markusgruen/RTMC/Hardware/RTMChub/RTMChub_V0.1_page1of2.pdf

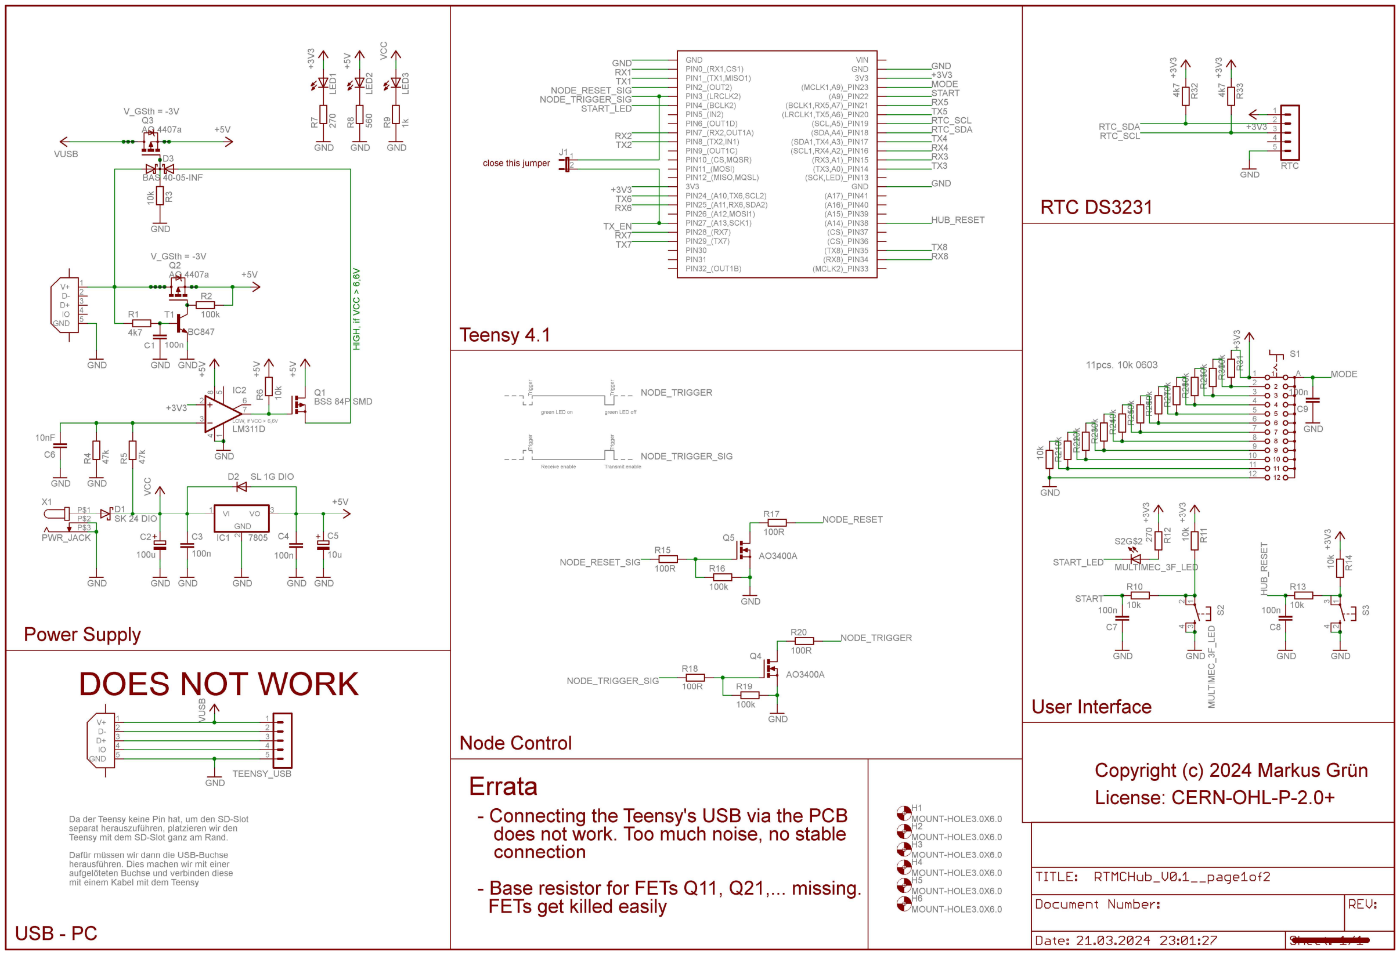
[picture p8: page 1]
