markusgruen/RTMC/Hardware/RTMChub/RTMChub_V0.1_page2of2.pdf

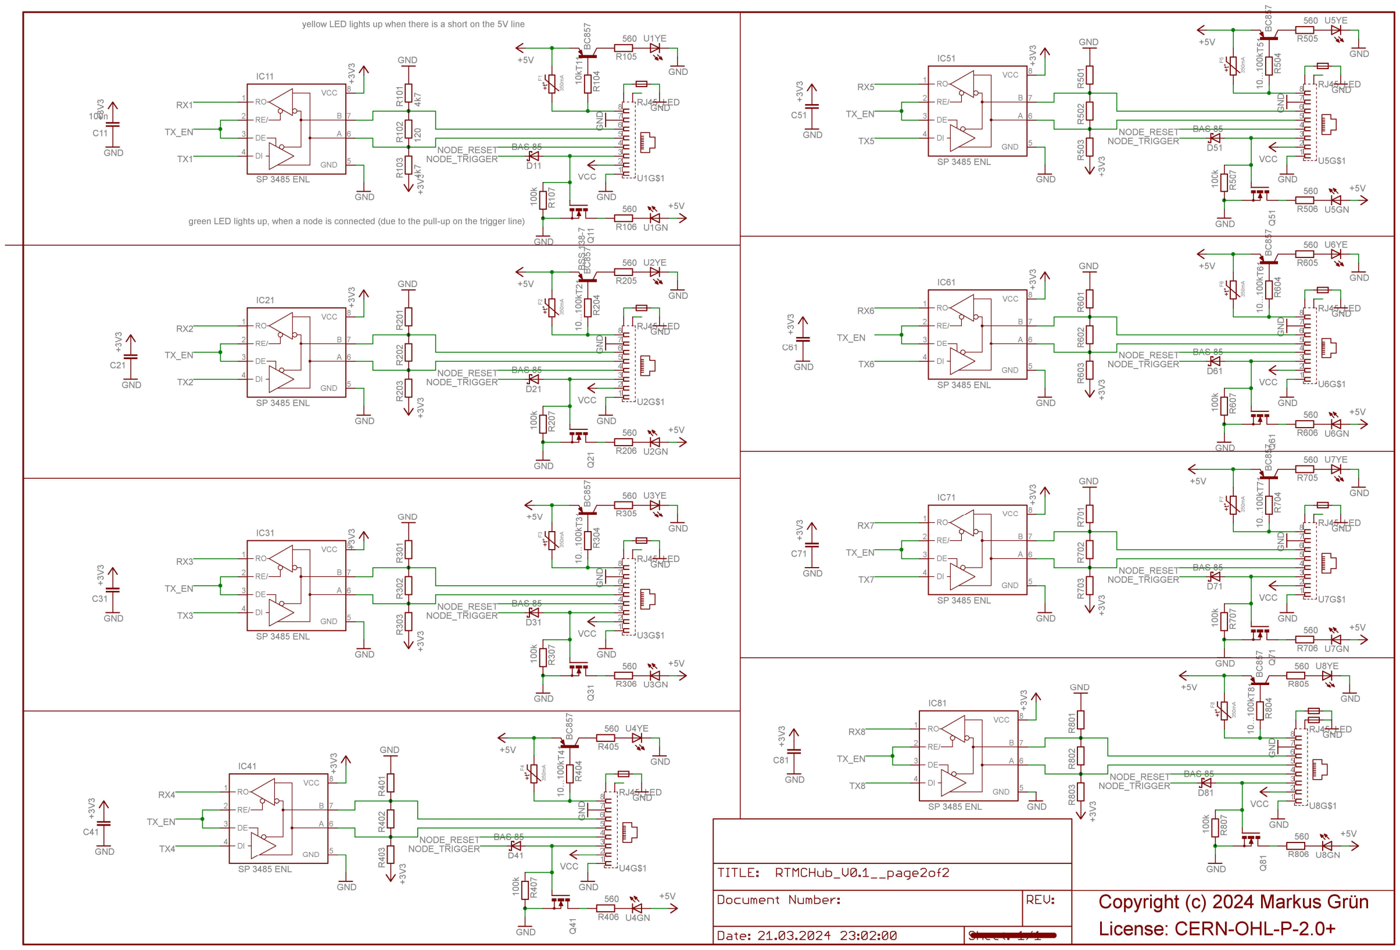
[picture p9: page 1]
