markusgruen/RTMC/Hardware/RTMCnode/RTMCnode_V0.1.pdf

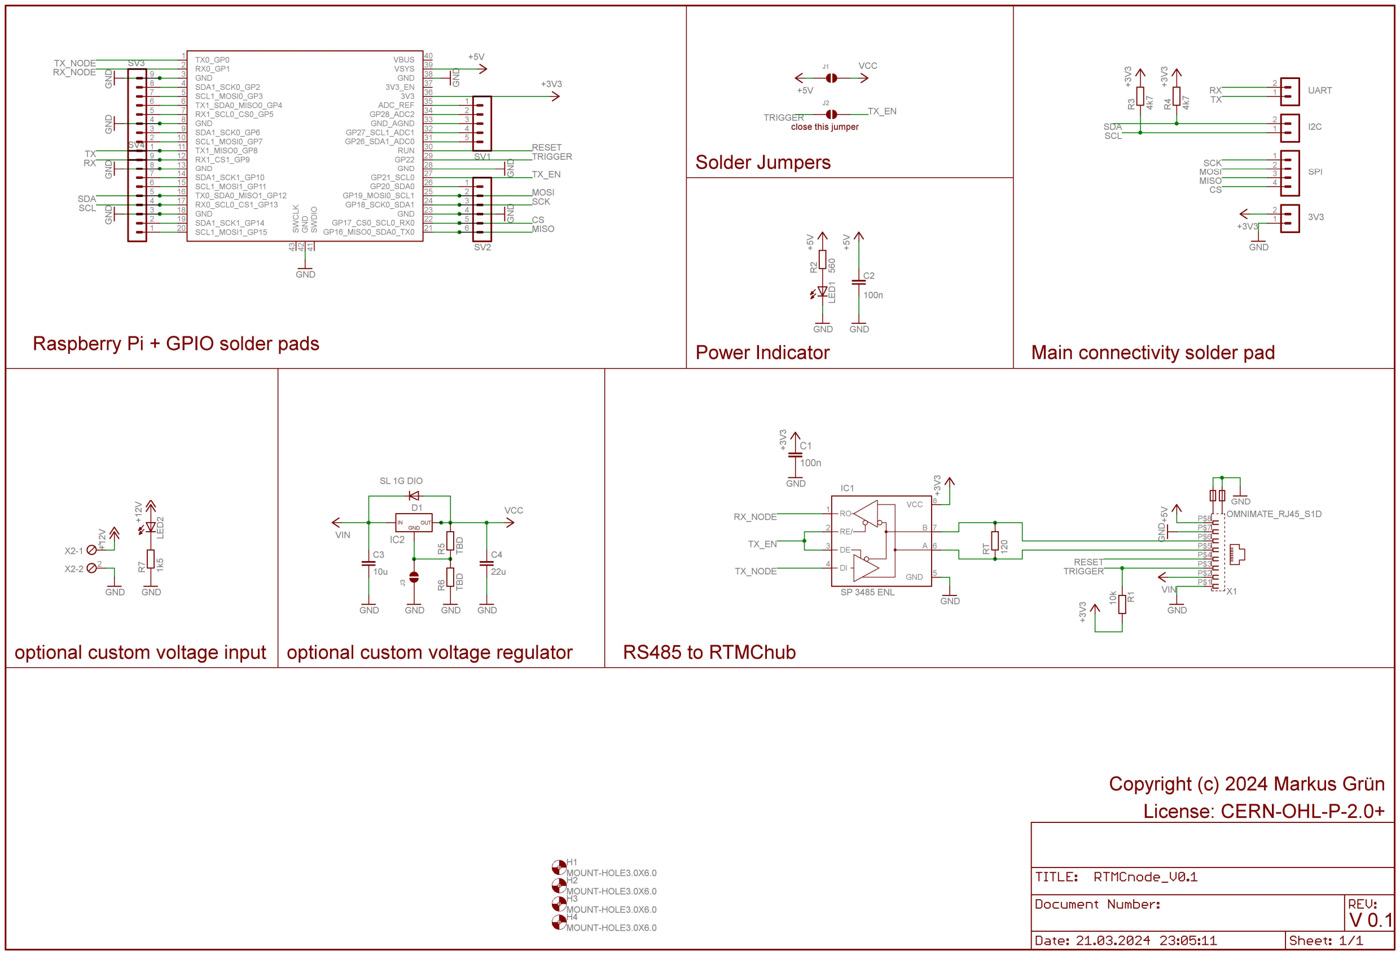
[picture p10: page 1]
