markusgruen/RTMC/doc/Arduino_ADXL355.jpg

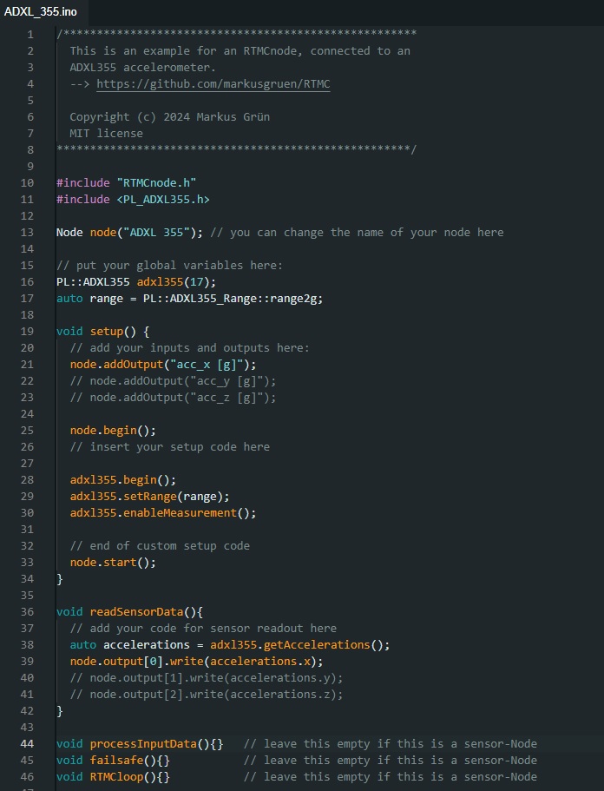
doc/Arduino_ADXL355.jpg
