markusgruen/RTMC/doc/RTMC-node_1.jpg

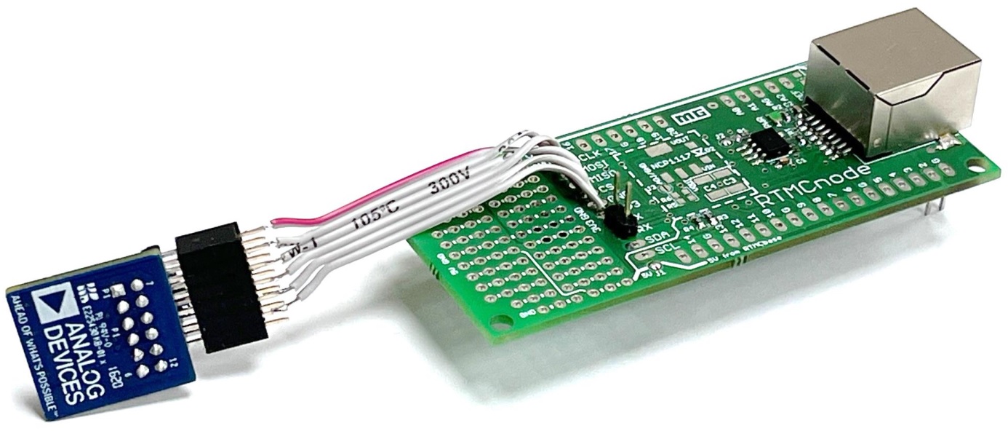
doc/RTMC-node_1.jpg
