markusgruen/RTMC/doc/RTMC-node_3.jpg

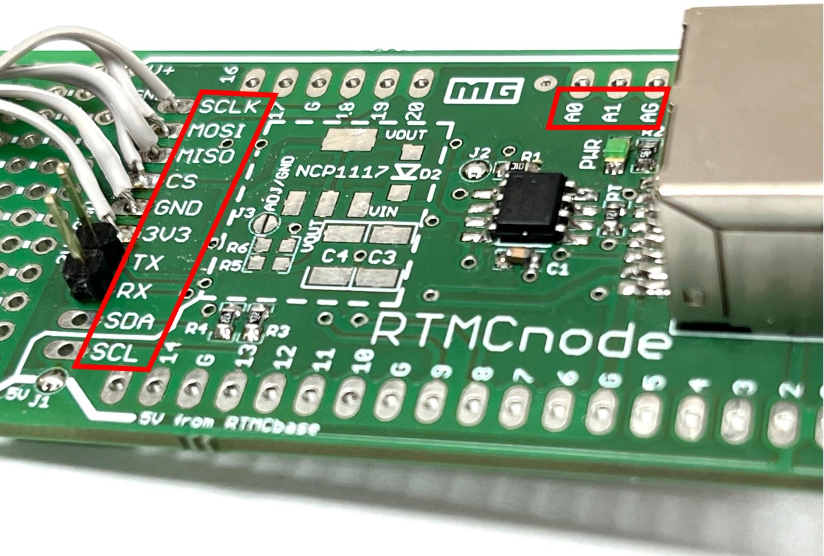
doc/RTMC-node_3.jpg
