markusgruen/RTMC/Hardware/BOM.xlsx

Sheet: RTMhub
 | Qty | Name | Value | Function | Remark | Reichelt Order No. | Reichelt Link
Teensy & Node Control | 1 | UC1 | Teensy 4.1 | µC | do not solder on PCB, use pinheader | TEENSY 4.1 | https://www.reichelt.de/teensy-4-1-usb-ohne-header-teensy-4-1-p283580.html?search=teensy
 | 2 | - | male Pinheader 1x24 | Pinheader for Teensy |  | MPE 087-1-024 | https://www.reichelt.de/stiftleisten-2-54-mm-1x24-gerade-mpe-087-1-024-p119889.html?trstct=vrt_pdn&nbc=1
 | 2 | - | female Pinheader 1x26 | Socket for Teensy | shorten to 1x24 | BKL 10120954 | https://www.reichelt.de/buchsenleiste-2-54mm-1x26-gerade-bkl-10120954-p266679.html?&nbc=1
 | 1 | J1 | male Pinheader 1x2 | Jumper | jumper required | MPE 087-1-002 | https://www.reichelt.de/stiftleisten-2-54-mm-1x02-gerade-mpe-087-1-002-p119879.html?trstct=pol_0&nbc=1
 | 4 | R15, R17, R18, R20 | 100R |  |  | SMD-0603 100 | https://www.reichelt.de/smd-widerstand-0603-100-ohm-100-mw-1--smd-0603-100-p89418.html?&nbc=1
 | 2 | R16, R19 | 100k |  |  | SMD-0603 100K | https://www.reichelt.de/smd-widerstand-0603-100-kohm-100-mw-1--smd-0603-100k-p89454.html?&nbc=1
 | 2 | Q4, Q5 | AO3400A | N-ch Mosfet |  | AO3400A | https://www.reichelt.de/mosfet-n-kanal-30-v-5-7-a-rds-on-0-018-ohm-sot-23-ao3400a-p166490.html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
User Interface | 1 | S1 | Rotary Switch, 1x12 | Mode switch |  | DS 1PC | https://www.reichelt.de/stufen-drehschalter-1-pol-12-stellungen-printk--ds-1pc-p7211.html?&nbc=1
 | 1 | S2 | Multimec Button, LED | Start button |  | TASTER 3FTH980 | https://www.reichelt.de/multimec-taster-led-beleuchtung-rt-taster-3fth980-p79702.html?&nbc=1
 | 1 | - | Cap for Multimec | Cap for Start button |  | KAPPE 1D11 | https://www.reichelt.de/kappe-fuer-taster-3f-rund-trans--kappe-1d11-p82189.html?&nbc=1
 | 1 | S3 | SMD button | Reset Button |  | TASTER 9315 | https://www.reichelt.de/smd-kurzhubtaster-vert-montage-hoehe-5-0mm-taster-9315-p44514.html?trstct=pol_12&nbc=1
 | 4 | R10, R11, R13, R14 | 10k |  |  | SMD-0603 10K | https://www.reichelt.de/smd-widerstand-0603-10-kohm-100-mw-1--smd-0603-10k-p89442.html?&nbc=1
 | 1 | R12 | 270R |  |  | SMD-0603 120 | https://www.reichelt.de/smd-widerstand-0603-120-ohm-100-mw-1--smd-0603-120-p89419.html?trstct=pos_0&nbc=1
 | 11 | R21…R31 | 10k |  |  | SMD-0603 10K | https://www.reichelt.de/smd-widerstand-0603-10-kohm-100-mw-1--smd-0603-10k-p89442.html?&nbc=1
 | 3 | C7, C8, C9 | 100n | Decoupling condensator |  | X7R-G0603 100N | https://www.reichelt.de/smd-vielschicht-0603-100-nf-10-16-v-x7r-125-c-ve-4k-x7r-g0603-100n-p31873.html?nbc=1
Power Supply | 1 | IC1 | LM7805 | Voltage Regulator | or similar Vreg | µA 7805 | https://www.reichelt.de/spannungsregler-fest-4-8--5-2-v-to-220--a-7805-p23443.html?trstct=pos_0&nbc=1
 | 1 | IC2 | LM311D | Komparator |  | LM 311 D SMD | https://www.reichelt.de/komparator-1-fach-so-8-lm-311-d-smd-p18712.html?&nbc=1
 | 1 | Q1 | BSS 84P | P-ch Mosfet |  | BSS 84P SMD | https://www.reichelt.de/mosfet-p-kanal-50-v-0-13-a-0-3-w-sot-23-bss-84p-smd-p41443.html?&nbc=1
 | 2 | Q2, Q3 | AO 4407a | P-ch Mosfet |  | AO 4407A | https://www.reichelt.de/mosfet-p-kanal-30-v-12-a-rds-on-0-0085-ohm-so-8-ao-4407a-p166495.html?&nbc=1
 | 1 | T1 | BC847 | NPN transistor |  | BC 847C DIO | https://www.reichelt.de/bipolartransistor-npn-45v-0-1a-0-25w-sot-23-bc-847c-dio-p219190.html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
 | 1 | D1 | SK 24 DIO | Schottky Diode |  | SK 24 DIO | https://www.reichelt.de/schottkydiode-40-v-2-a-do-214aa-sk-24-dio-p219596.html?&nbc=1
 | 1 | D2 | SL 1G DIO | Recovery diode |  | SL 1G DIO | https://www.reichelt.de/gleichrichterdiode-400-v-1-a-sod-123-sl-1g-dio-p219603.html?&nbc=1
 | 1 | D3 | BAS 40-05-INF | Dual Schottky Diode |  | BAS 40-05 INF | https://www.reichelt.de/duale-schottky-dioden-gemeinsame-kathode-40-v-0-12-a-sot-23-bas-40-05-inf-p219312.html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
 | 1 | R1 | 4k7 |  |  | SMD-0603 4,7K | https://www.reichelt.de/smd-widerstand-0603-4-7-kohm-100-mw-1--smd-0603-4-7k-p89438.html?&nbc=1
 | 1 | R2 | 100k |  |  | SMD-0603 100K | https://www.reichelt.de/smd-widerstand-0603-100-kohm-100-mw-1--smd-0603-100k-p89454.html?&nbc=1
 | 2 | R3, R6 | 10k |  |  | SMD-0603 10K | https://www.reichelt.de/smd-widerstand-0603-10-kohm-100-mw-1--smd-0603-10k-p89442.html?&nbc=1
 | 2 | R4, R5 | 47k |  |  | SMD-0603 47K | https://www.reichelt.de/smd-widerstand-0603-47-kohm-100-mw-1--smd-0603-47k-p89450.html?trstct=pos_0&nbc=1
 | 1 | R7 | 270R |  |  | SMD-0603 270 | https://www.reichelt.de/smd-widerstand-0603-270-ohm-100-mw-1--smd-0603-270-p89423.html?trstct=pos_0&nbc=1
 | 1 | R8 | 560R | LED resistor |  | SMD-0603 560 | https://www.reichelt.de/smd-widerstand-0603-560-ohm-100-mw-1--smd-0603-560-p89427.html?&nbc=1
 | 1 | R9 | 1k |  |  | SMD-0603 1,0K | https://www.reichelt.de/smd-widerstand-0603-1-0-kohm-100-mw-1--smd-0603-1-0k-p89430.html?trstct=pol_0&nbc=1
 | 3 | C1, C3, C4 | 100n | Decoupling condensator |  | X7R-G0603 100N | https://www.reichelt.de/smd-vielschicht-0603-100-nf-10-16-v-x7r-125-c-ve-4k-x7r-g0603-100n-p31873.html?nbc=1
 | 1 | C6 | 10n |  |  | X7R-G0603 10N | https://www.reichelt.de/smd-vielschicht-keramikkondensator-10n-10--x7r-g0603-10n-p31870.html?&nbc=1
 | 1 | C2 | 100u |  | adapt as required by the Vreg | FK 100/25 XP | https://www.reichelt.de/elko-smd-100-f-25v-105-c-low-esr-fk-100-25-xp-p175023.html?trstct=pol_2&nbc=1
 | 1 | C5 | 10u |  | adapt as required by the Vreg | SMD ELKO 10/16 | https://www.reichelt.de/smd-chip-elko-10-f-16volt-smd-elko-10-16-p31906.html?&nbc=1
 | 1 | X5 | Mirco USB | Micro USB for Power input |  | MIC USB ABBU | https://www.reichelt.de/micro-usb-einbaubuchse-typ-ab-5-pol-smd-mic-usb-abbu-p155040.html?trstct=pos_0&nbc=1
 | 1 | X1 | Power Jack | Power Input |  | CLIFF FCR681465P | https://www.reichelt.de/einbaukupplung-loetstifte-cliff-fcr681465p-p227726.html?&nbc=1
 | 3 | LED1…3 | LED 3mm | Power Indicator |  | LED 3MM GN | https://www.reichelt.de/led-3-mm-bedrahtet-gruen-74-mcd-38--led-3mm-gn-p10227.html?trstct=pol_5&nbc=1
8x Node Communication | 8 | IC11, IC21,…IC81 | SP 3485 ENL | RS485 Transceiver |  | SP 3485 ENL | https://www.reichelt.de/rs485-422-1-treiber-1-empfaenger-so-8-sp-3485-enl-p166271.html?&nbc=1
 | 16 | R101, R201,…, R801 R103, R203,…R803 | 4k7 |  |  | SMD-0603 4,7K | https://www.reichelt.de/smd-widerstand-0603-4-7-kohm-100-mw-1--smd-0603-4-7k-p89438.html?&nbc=1
 | 8 | R102, R202,…R802 | 120R | RS485 Terminator |  | SMD-0603 120 | https://www.reichelt.de/smd-widerstand-0603-120-ohm-100-mw-1--smd-0603-120-p89419.html?&nbc=1
 | 8 | R104, R204,…, R804 | 10k |  |  | SMD-0603 10K | https://www.reichelt.de/smd-widerstand-0603-10-kohm-100-mw-1--smd-0603-10k-p89442.html?&nbc=1
 | 16 | R105, R205,…, R805 R106, R206,…, R806 | 560R | LED resistor |  | SMD-0603 560 | https://www.reichelt.de/smd-widerstand-0603-560-ohm-100-mw-1--smd-0603-560-p89427.html?&nbc=1
 | 8 | R107, R207,…, R807 | 100k |  |  | SMD-0603 100K | https://www.reichelt.de/smd-widerstand-0603-100-kohm-100-mw-1--smd-0603-100k-p89454.html?&nbc=1
 | 8 | C11, C21, …., C81 | 100n | Decoupling condensator |  | X7R-G0603 100N | https://www.reichelt.de/smd-vielschicht-0603-100-nf-10-16-v-x7r-125-c-ve-4k-x7r-g0603-100n-p31873.html?nbc=1
 | 8 | F1…F8 | Polyfuse 350mA | Fuse |  | PTC FSMD0350805 | https://www.reichelt.de/ptc-sicherung-smd-0805-6v-350ma-rueckstellend-ptc-fsmd0350805-p279337.html?nbc=1
 | 8 | D11, D21,…D81 | BAS 85 | Schottky Diode |  | BAS 85 VIS | https://www.reichelt.de/kleinsignal-schottky-diode-30-v-0-2-a-sod-80-bas-85-vis-p219617.html?&nbc=1
 | 8 | Q11, Q21,…, Q81 | BSS 138 | N-ch Mosfet |  | BSS 138-7-F DII | https://www.reichelt.de/mosfet-n-ch-50v-0-2a-0-3w-sot-23-bss-138-7-f-dii-p219226.html?&nbc=1
 | 8 | T11, T21,…, T81 | BC857 | PNP transistor |  | BC 857C SMD | https://www.reichelt.de/bipolartransistor-pnp-45v-0-1a-0-25w-sot-23-bc-857c-smd-p18573.html?&nbc=1
 | 8 | U1,…U8 | CAT5 T1D 3.2E4G | RJ45 connector |  | CAT5 T1D 3.2E4G | https://www.reichelt.de/rj45-buchse-90-tht-cat-5-cat5-t1d-3-2e4g-p257576.html?&nbc=1
RTC | 2 | R32, R33 | 4k7 | i2c pull-up |  | SMD-0603 4,7K | https://www.reichelt.de/smd-widerstand-0603-4-7-kohm-100-mw-1--smd-0603-4-7k-p89438.html?&nbc=1
 | 1 | - | male Pinheader 1x5 | Pinheader for RTC eval kit |  | MPE 087-1-005 | https://www.reichelt.de/stiftleisten-2-54-mm-1x05-gerade-mpe-087-1-005-p119882.html?trstct=vrt_pdn&nbc=1
 | 1 | - | DS3231 w/ battery |  | not available at Reichelt

Sheet: RTMCnode
Qty | Name | Value | Function | Reichelt Order No. | Reichelt Link
Minimum configuration
1 | U1 | Raspberry Pi pico | µC | RASP PI PICO | https://www.reichelt.de/raspberry-pi-pico-rp2040-cortex-m0-microusb-rasp-pi-pico-p295706.html?&nbc=1
1 | IC1 | SP 3485 ENL | RS485 Transceiver | SP 3485 ENL | https://www.reichelt.de/rs485-422-1-treiber-1-empfaenger-so-8-sp-3485-enl-p166271.html?&nbc=1
1 | X1 | Omnimate RJ4 S1D | RJ45 connector | CAT5 S1D 2.7N4N | https://www.reichelt.de/rj45-buchse-90-smd-cat-5-cat5-s1d-2-7n4n-p257574.html?&nbc=1
1 | R1 | 10k | Pull-up for Trigger | SMD-0603 10K | https://www.reichelt.de/smd-widerstand-0603-10-kohm-100-mw-1--smd-0603-10k-p89442.html?&nbc=1
1 | R2 | 560R | LED resistor | SMD-0603 560 | https://www.reichelt.de/smd-widerstand-0603-560-ohm-100-mw-1--smd-0603-560-p89427.html?&nbc=1
2 | R3, R4 | 4k7 | I2C pull-up | SMD-0603 4,7K | https://www.reichelt.de/smd-widerstand-0603-4-7-kohm-100-mw-1--smd-0603-4-7k-p89438.html?&nbc=1
1 | RT | 120R | RS485 Terminator | SMD-0603 120 | https://www.reichelt.de/smd-widerstand-0603-120-ohm-100-mw-1--smd-0603-120-p89419.html?&nbc=1
2 | C1, C2 | 100n | Decoupling condensator | X7R-G0603 100N | https://www.reichelt.de/smd-vielschicht-0603-100-nf-10-16-v-x7r-125-c-ve-4k-x7r-g0603-100n-p31873.html?nbc=1
1 | LED1 | green | Power Indicator | WUE 150060GS750 | https://www.reichelt.de/led-smd-0603-gruen-220-mcd-140--wue-150060gs750-p231764.html?trstct=pol_3&nbc=1
Optional custom voltage regulator
1 | IC2 | 1117 Type | Voltage Regulator
1 | R5 | custom
? | R6 | custom
1 | D1 | SL 1G DIO | Recovery diode | SL 1G DIO | https://www.reichelt.de/gleichrichterdiode-400-v-1-a-sod-123-sl-1g-dio-p219603.html?&nbc=1
1 | C | custom
1 | C | custom
Optional external power supply
1 | X2 | DG308 2,54-2 | ext. power connector | DG308 2,54-2 | https://www.reichelt.de/leiterplattenklemme-2-polig-rm-2-54-mm-dg308-2-54-2-p276214.html?&nbc=1
1 | R7 | 1k5 | LED resistor | SMD-0603 1,5K | https://www.reichelt.de/smd-widerstand-0603-1-5-kohm-100-mw-1--smd-0603-1-5k-p89432.html?&nbc=1
1 | LED2 | green | ext. Power Indicator | WUE 150060GS750 | https://www.reichelt.de/led-smd-0603-gruen-220-mcd-140--wue-150060gs750-p231764.html?trstct=pol_3&nbc=1
