markusgruen/RTMC/(commit log)

2023-10-20 Version 0.3 - Sensor- und Aktor-Nodes funktionieren, Examples für RTMChub und RTMCnode erstellt
2024-03-21 Hardware files added. Pictures added
    [BOM.xlsx, RTMChub_V0.1_BOM.xlsx, RTMCnode_V0.1_BOM.xlsx]
